istvanzk/WStation/README.md

# Home Weather Station built with Arduino Pro Mini and Raspberry PI (3 A+)

**Note: This repo contains 'release' code and schematics - January 2026 (v3.6)**

## Dependencies

- [OBH Nordica eHome wind meter system 4931][13] (or similar set of sensor)
- [Arduino Pro Mini 328 3.3V/8MHz][8]
- [Raspberry Pi 3 A+][9] and the [7″ touchscreen monitor][11]
- The [forked & modified RadioHead library][1] with support of [RFM22B][2] and [RFM69HCW][10] based radio modules for Raspberry Pi. 
- The original [RadioHead Packet Radio library][3] for embedded microprocessors maintained by Mike McCauley. 
- The original [BCM2835][12] library for Raspbery Pi maintained by Mike McCauley. See [install notes](#BCM2835-library) below.
- Arduino libraries for communication with the [Barometric Pressure Sensor Breakout - BMP180][4] and [Humidity and Temperature Sensor Breakout - SHT15][5]
- Python module for [POSIX IPC Semaphores, Shared Memory and Message Queues][6]
- Pyhton library [Kivy][7]

## GUI (v1.0)
- The main screen - updated every 45 seconds
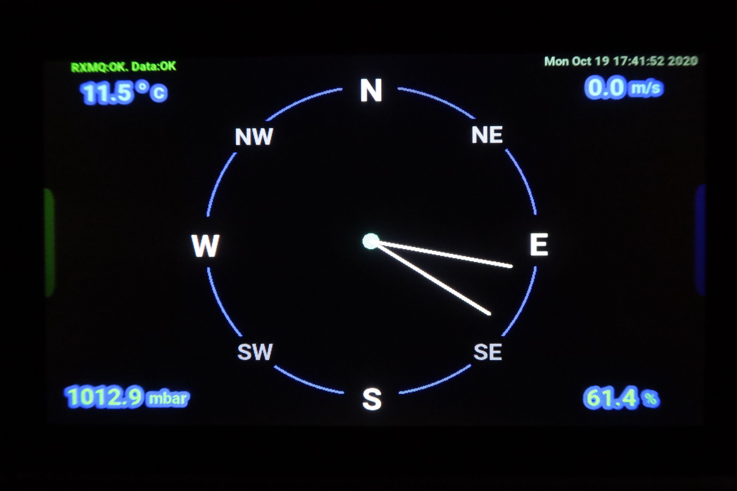
[picture p1: docs/mainscreen.jpg]
Main screen


- The trace screen - for last 15 minutes
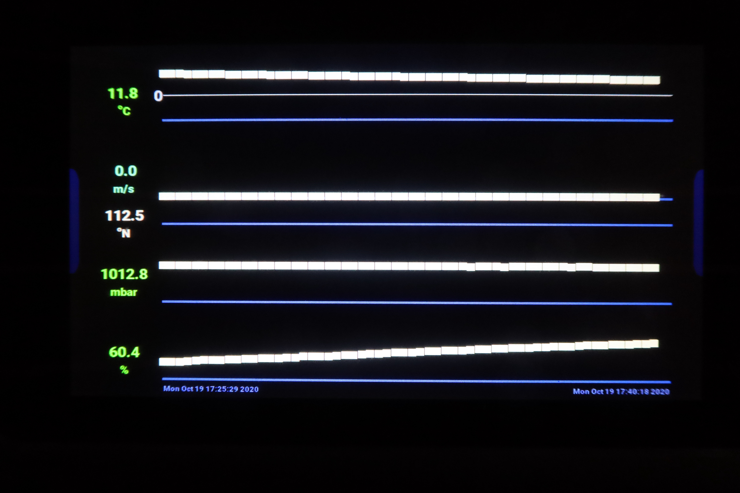
[picture p2: docs/tracescreen.jpg]
Traces screen


## Code structure (v3.6)

*arduino*
- *KiCad*: KiCad circuit diagrams
- *WStation*: code
  - *sensrfm*: client code for collecting weather sensor data and sending it via RFM69HCW or RFM22B radio
  - other folders: test code for sensors and radio

*raspi*
- *KiCad*: KiCad circuit diagrams
- *kivy*: Kivy GUI code (client_mq.py, display.py and screens.kv)
- *rfm*: C code for reading the weather data transmissions via the RFM69HCW or RFM22B radio and sending them via POSIX MessageQueue to the Kivy GUI (server_mq.cpp). See [install notes](#RFM/server_mq) below.

*docs*
- Schematics and pictures

## Install notes

### General dependencies
```
sudo apt install -U build-essential libcap2 libcap-dev libsystemd-dev 
sudo apt install -U python3-kivy python3-systemd
```

### BCM2835 library

Download [BCM2835][12] library and extract it. Based on the [orginal intallation guide][12] follow these steps:
1) Add user to kmem group, allow write access to /dev/mem by members of kmem group, then rreboot and continue with step 2:
```
sudo adduser $USER kmem
echo 'SUBSYSTEM=="mem", KERNEL=="mem", GROUP="kmem", MODE="0660"' | sudo tee /etc/udev/rules.d/98-mem.rules
```
2) Uncomment the #define BCM2835_HAVE_LIBCAP in bcm2835.h
3) Configure with `LIBS=-lcap ./configure`
4) Build and check (`make`, `sudo make check`) and install (`make install`)

### RFM/server_mq

```
make
sudo setcap cap_sys_rawio+ep server_mq
```

[1]: https://github.com/istvanzk/RadioHead
[2]: https://www.hoperf.com/modules/rf_transceiver/RFM22BW.html
[3]: http://www.airspayce.com/mikem/arduino/RadioHead/
[4]: https://github.com/sparkfun/BMP180_Breakout_Arduino_Library
[5]: https://github.com/sparkfun/SHT15_Breakout
[6]: https://github.com/osvenskan/posix_ipc 
[7]: https://kivy.org
[8]: https://www.arduino.cc/en/Main/ArduinoBoardProMini
[9]: https://www.raspberrypi.org/blog/new-product-raspberry-pi-3-model-a
[10]: https://www.hoperf.com/modules/rf_transceiver/RFM69HCW.html
[11]: https://www.raspberrypi.org/products/raspberry-pi-touch-display/
[12]: http://www.airspayce.com/mikem/bcm2835/
[13]: https://github.com/istvanzk/WStation/blob/master/docs/OBHeHome4931.png
