istvanzk/WStation/arduino/WStation/README.md

## Arduino code

The *\*_test* folders contain scripts used to test the individual components connected to the [Arduino board Pro Mini][1].
The final code is in the folder *sensrfm*.

### BOM 
[Arduino board Pro Mini][1]

[RFM22B-S2][2]

[SparkFun Barometric Pressure Sensor Breakout - BMP180][3]

[SparkFun Humidity and Temperature Sensor Breakout - SHT15][4]

[Octal Bus Transceiver Tri-State - 74HC245][5]

### Connections, wiring, sensors

[Full schematics][6]

[1]: https://www.arduino.cc/en/Main/ArduinoBoardProMini
[2]: https://www.sparkfun.com/products/retired/10154
[3]: https://github.com/sparkfun/BMP180_Breakout_Arduino_Library
[4]: https://github.com/sparkfun/SHT15_Breakout
[5]: http://www.futurlec.com/74HC/74HC245.shtml
[6]: https://github.com/istvanzk/WStation/blob/master/docs/arduino_wstation.pdf
