istvanzk/WStation/raspi/KiCad/README.md

## KiCad EDA libraries

These are the [KiCad/EESchema][1] libraries used to generate the Raspberry PI related [schematics files][2] V1.01.

[1]: http://www.kicad-pcb.org
[2]: https://github.com/istvanzk/WStation/tree/master/docs
