istvanzk/WStation/arduino/KiCad/README.md

## KiCad EDA libraries

These are the [KiCad/EESchema][1] libraries used to generate the Arduino related [schematics files][2].

[1]: http://www.kicad-pcb.org
[2]: https://github.com/istvanzk/WStation/tree/master/docs
