istvanzk/WStation/docs/OBHeHome4931.png

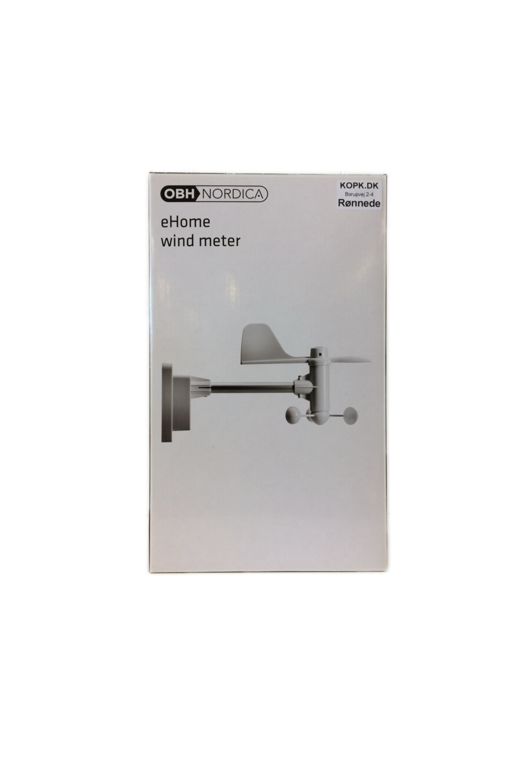
docs/OBHeHome4931.png
