istvanzk/WStation/docs/windsens.png

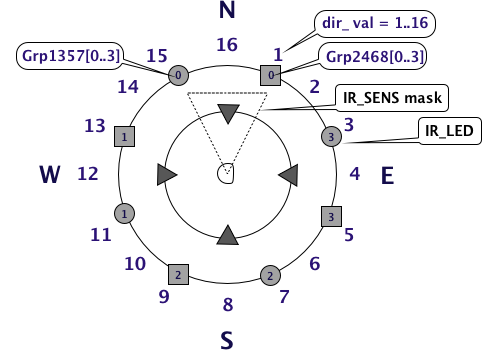
docs/windsens.png
