istvanzk/WStation/docs/arduino_ftdi.pdf

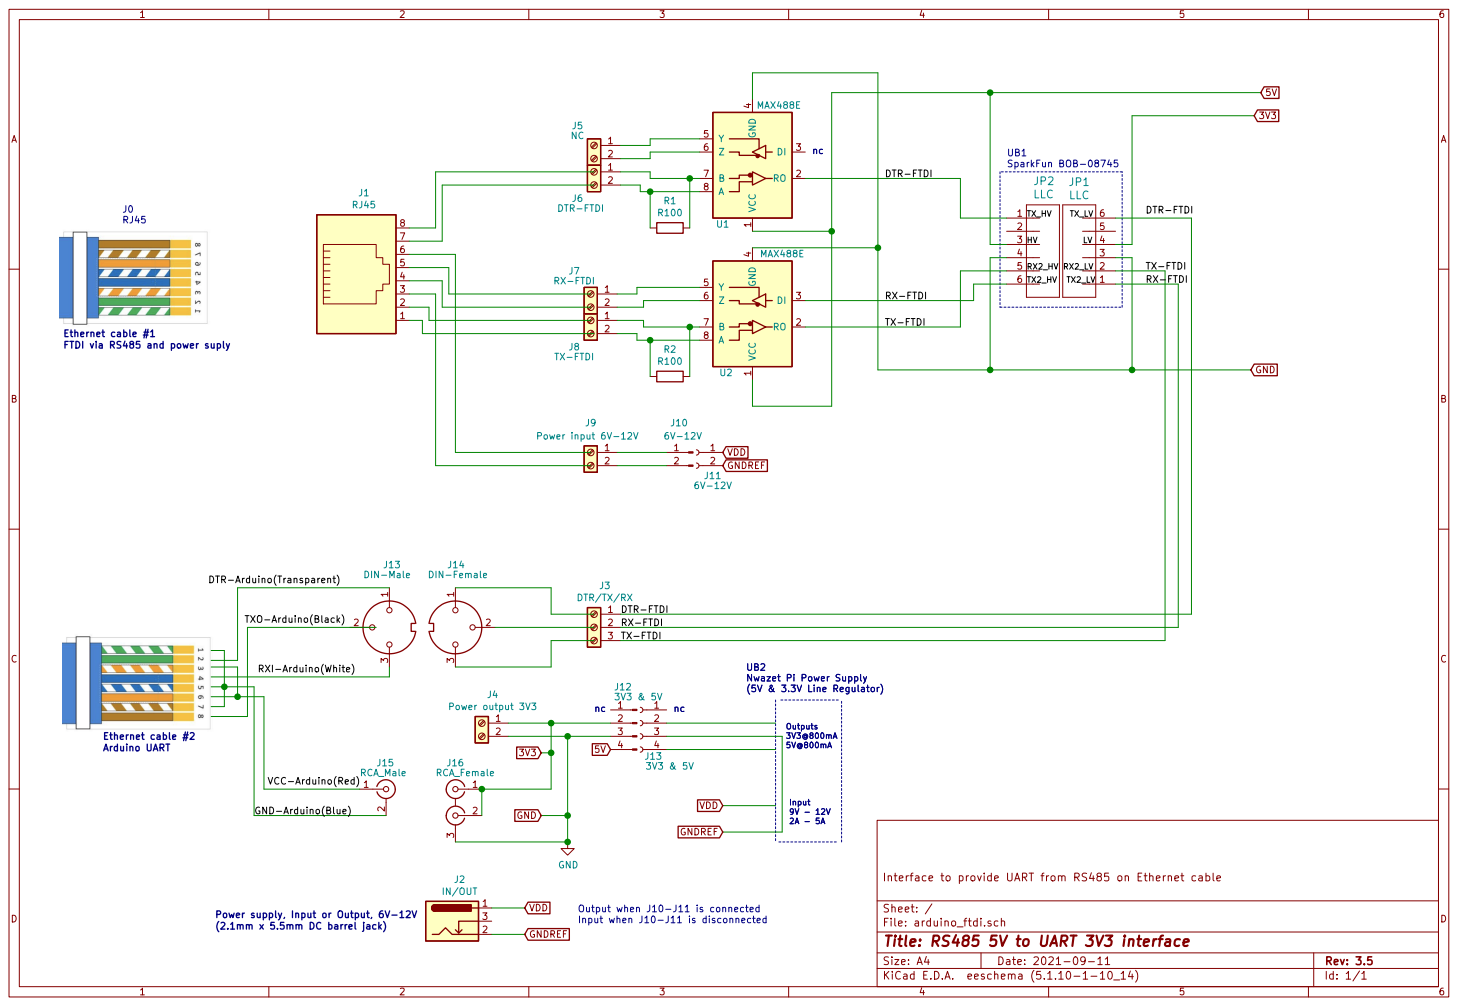
[picture p5: page 1]

Ethernet cable #1 FTDI via RS485 and power suply Ethernet cable #2 Arduino UART

UB1 SparkFun BOB-08745 UB2 Nwazet Pi Power Supply

TX-FTDI DTR-FTDI

5V@800mA UB2 Nwazet Pi Power Supply
2A - 5A Outputs 3V3@800mA

5V@800mA Output when J10-J11 is connected

Interface to provide UART from RS485 on Ethernet cable

File: arduino_ftdi.sch Sheet: /
Id: 1/1 Title: RS485 5V to UART 3V3 interface

Input when J10-J11 is disconnected Power supply, Input or Output, 6V-12V
(2.1mm x 5.5mm DC barrel jack)
