istvanzk/WStation/docs/raspi_wstation.pdf

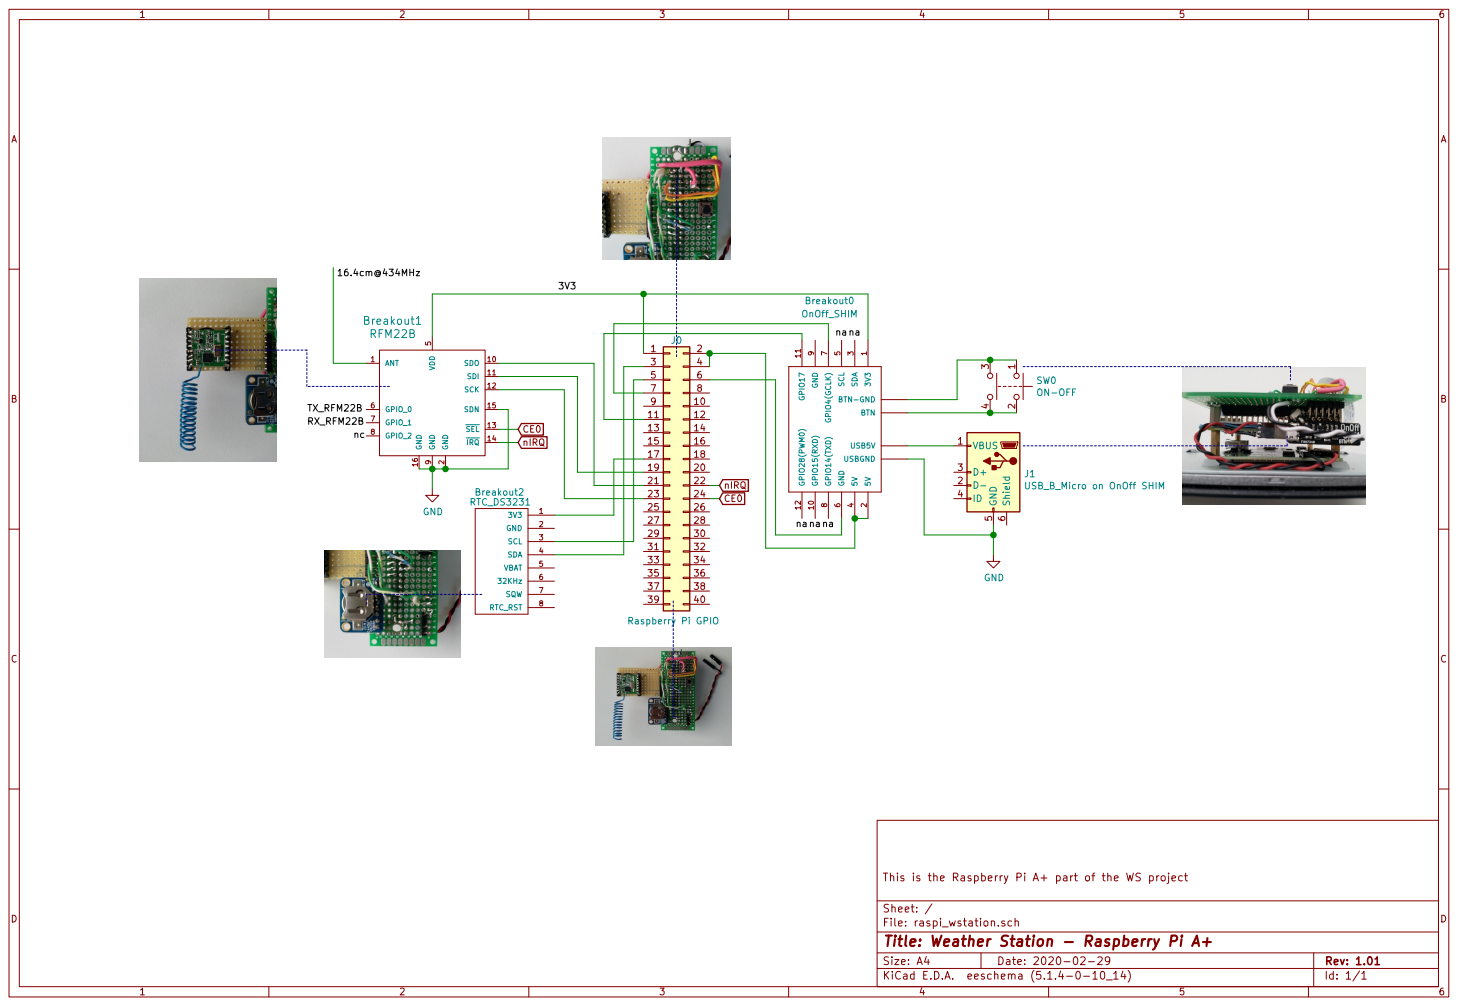
[picture p6: page 1]

9 SDO 10 SDI 11 SCK 12 SEL 13

9 | | 10

File: raspi_wstation.sch Sheet: / This is the Raspberry Pi A+ part of the WS project

Id: 1/1 Title: Weather Station - Raspberry Pi A+
