istvanzk/WStation/docs/usb_ftdi.pdf

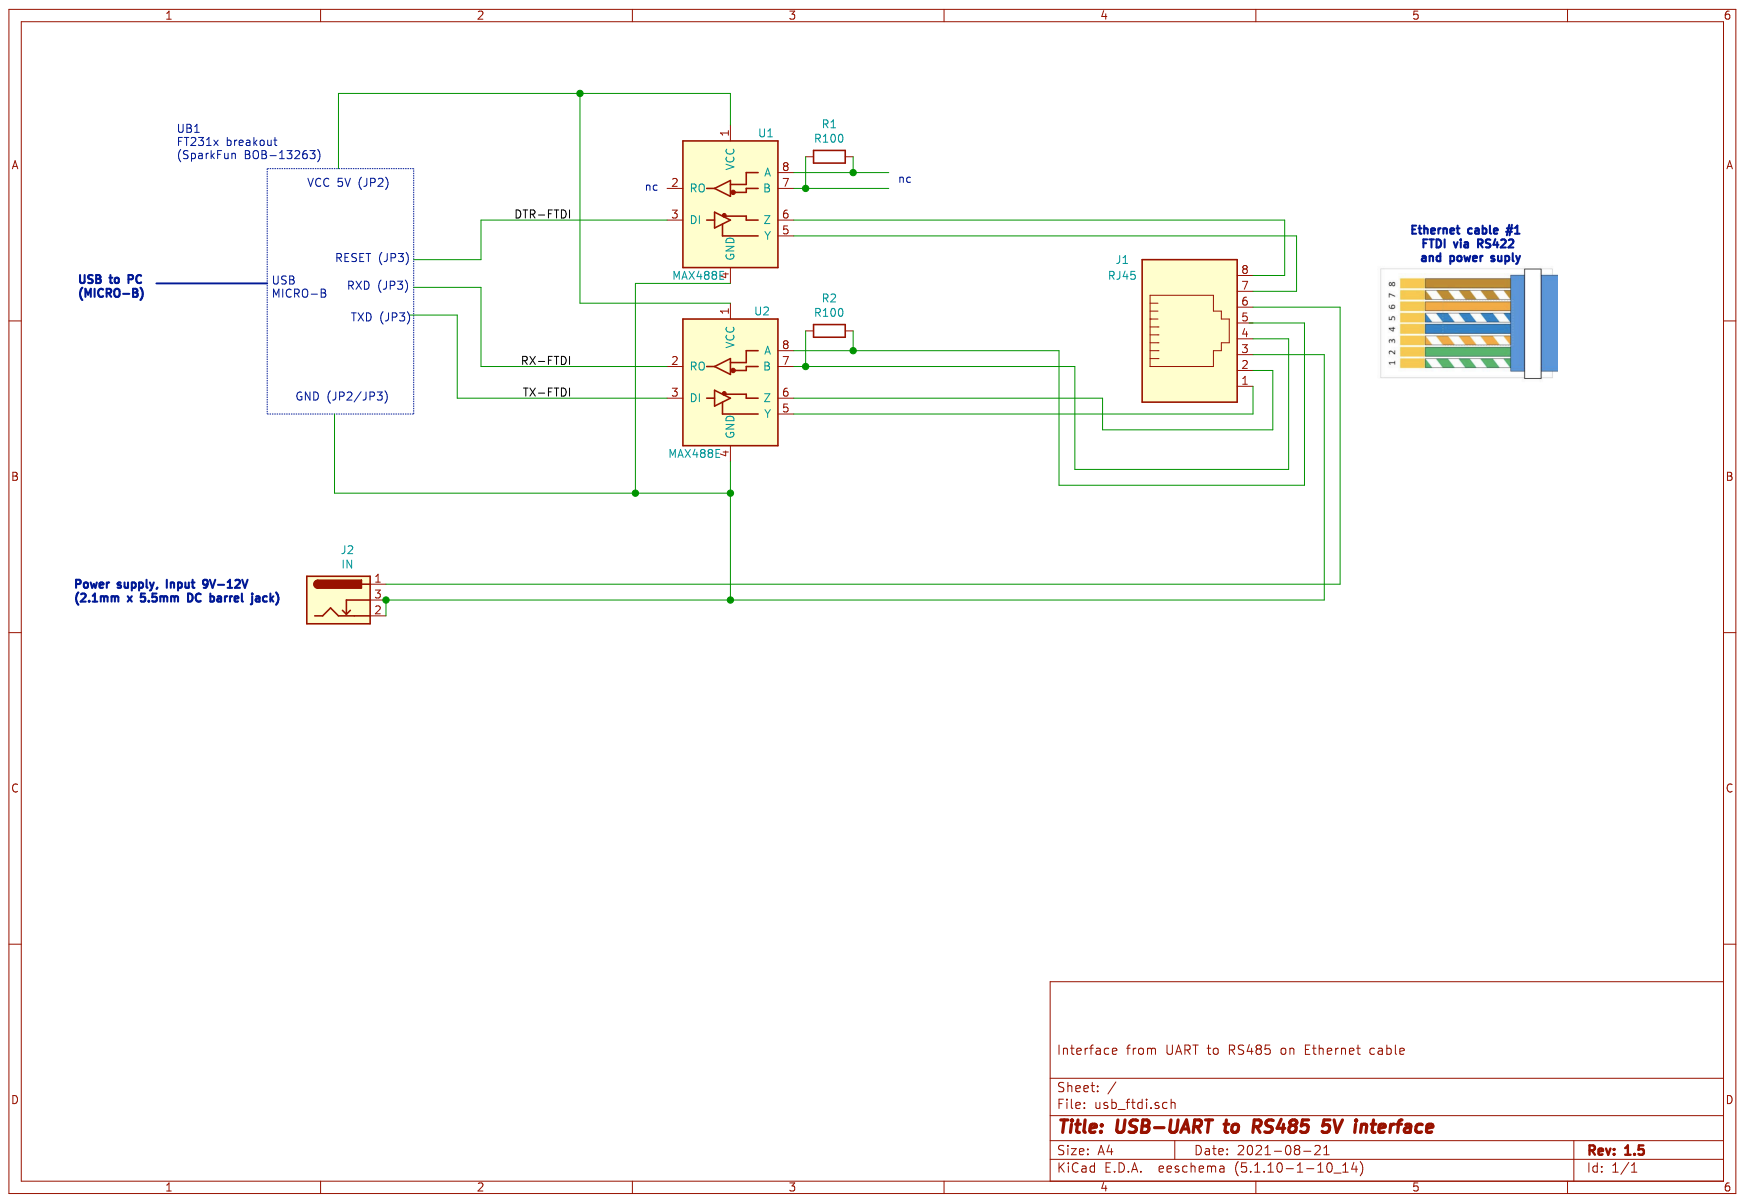
[picture p7: page 1]
