istvanzk/WStation/docs/arduino_wstation_rfm22.pdf

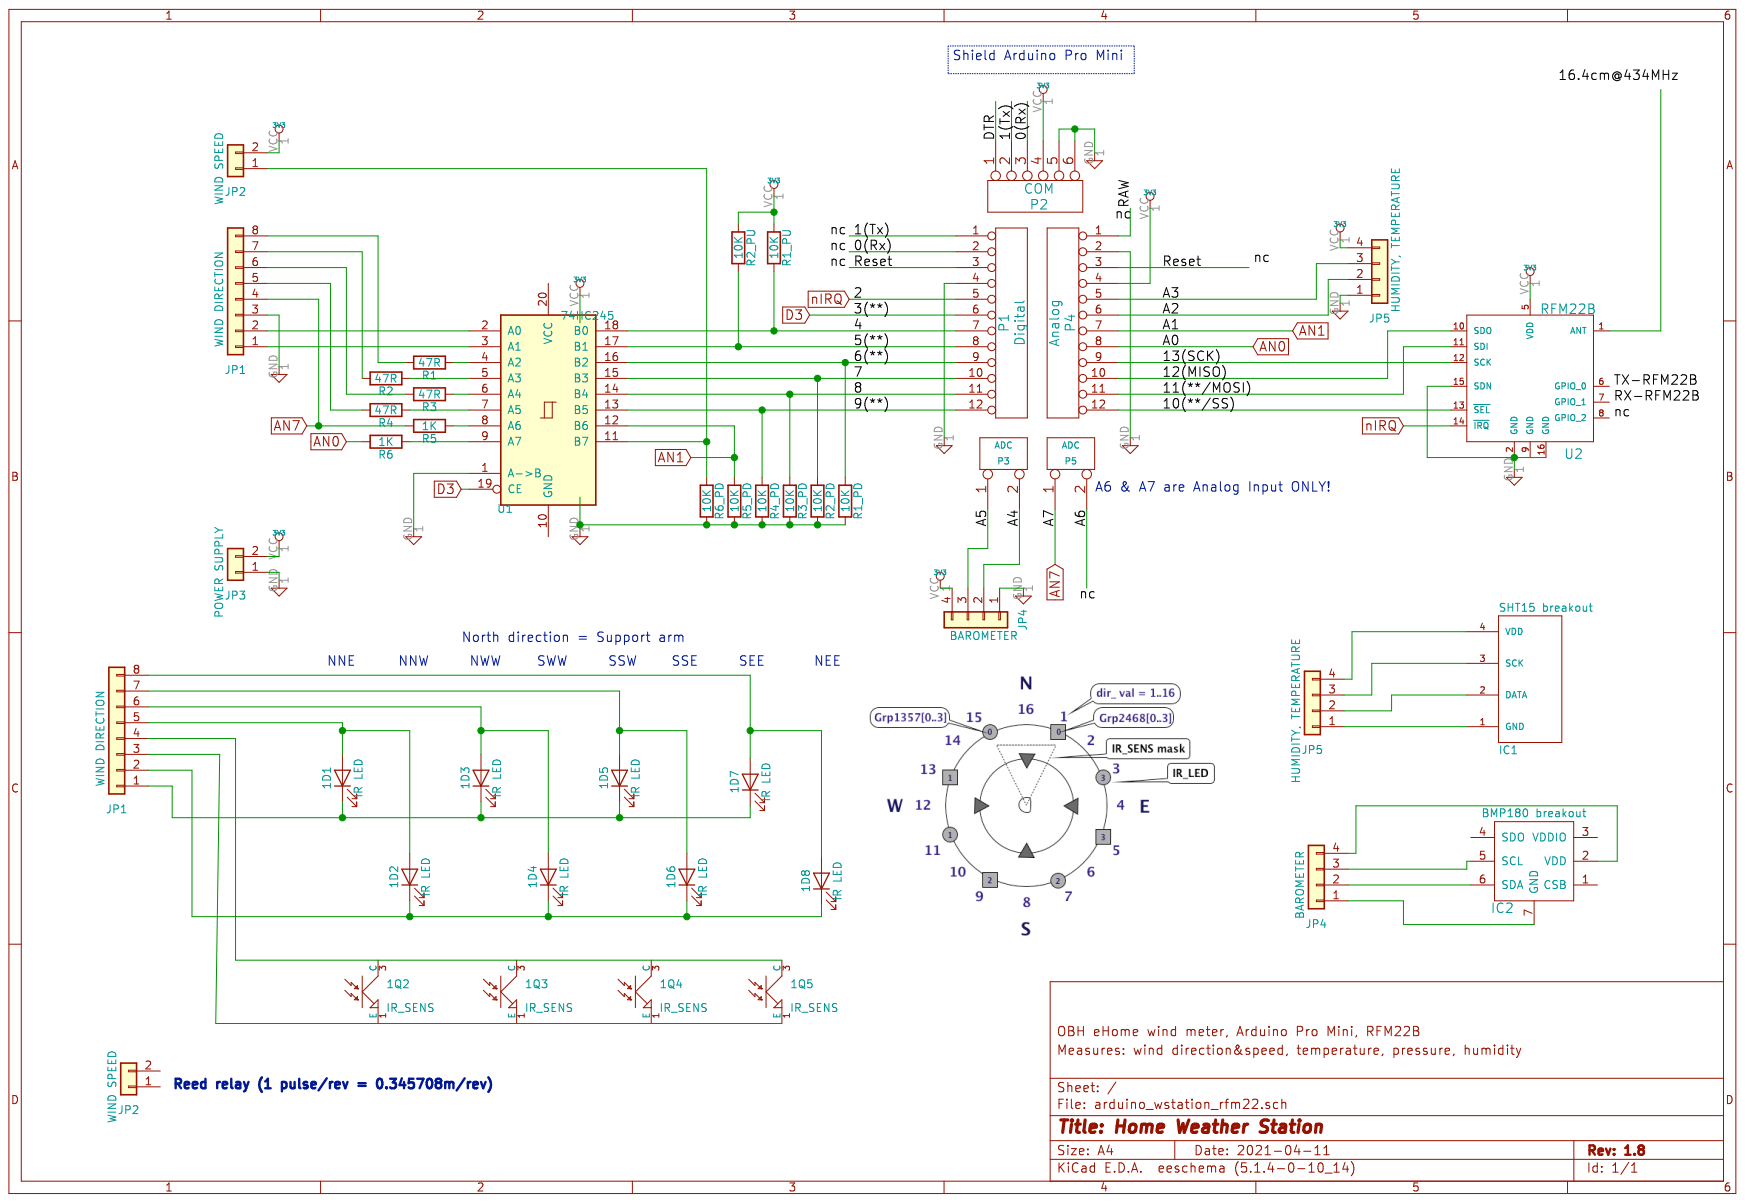
[picture p8: page 1]
