istvanzk/WStation/docs/arduino_wstation_rfm69.pdf

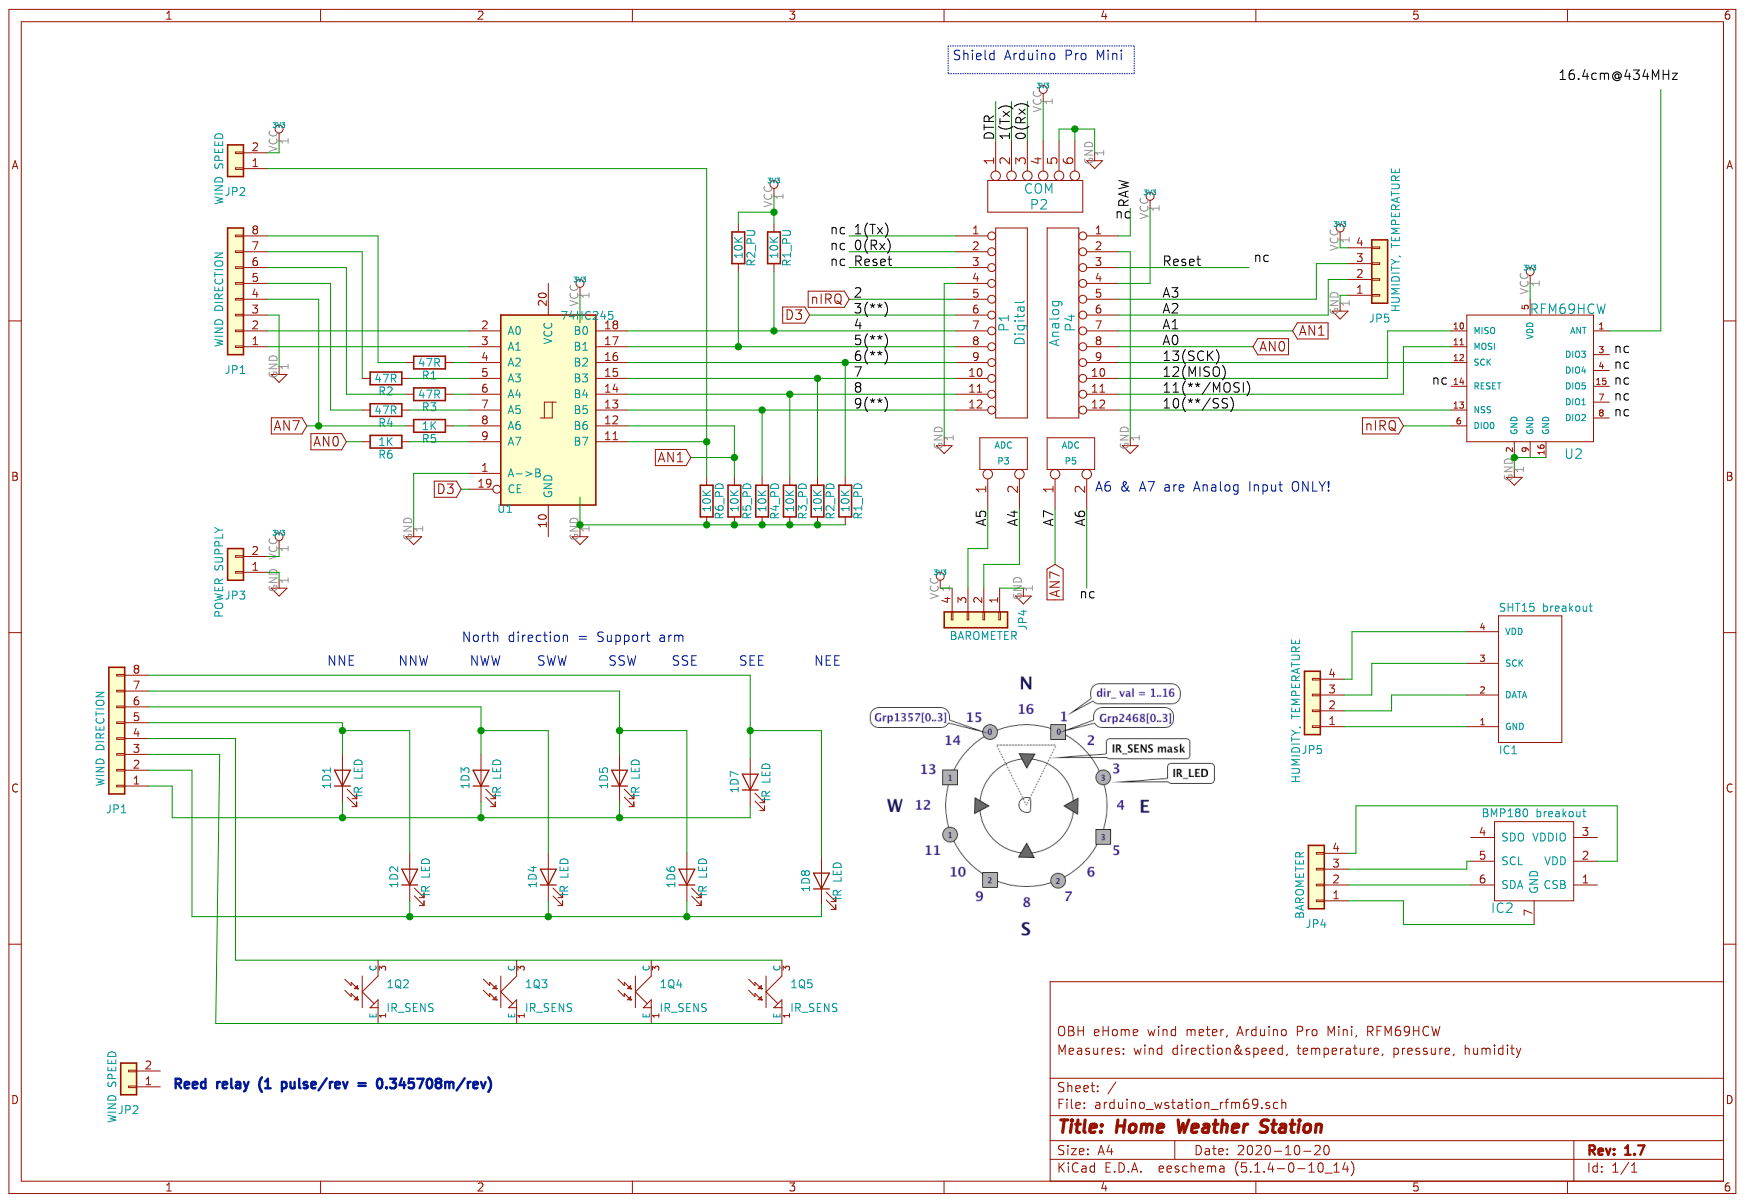
[picture p9: page 1]
