istvanzk/WStation/docs/raspi_wstation_rfm69.pdf

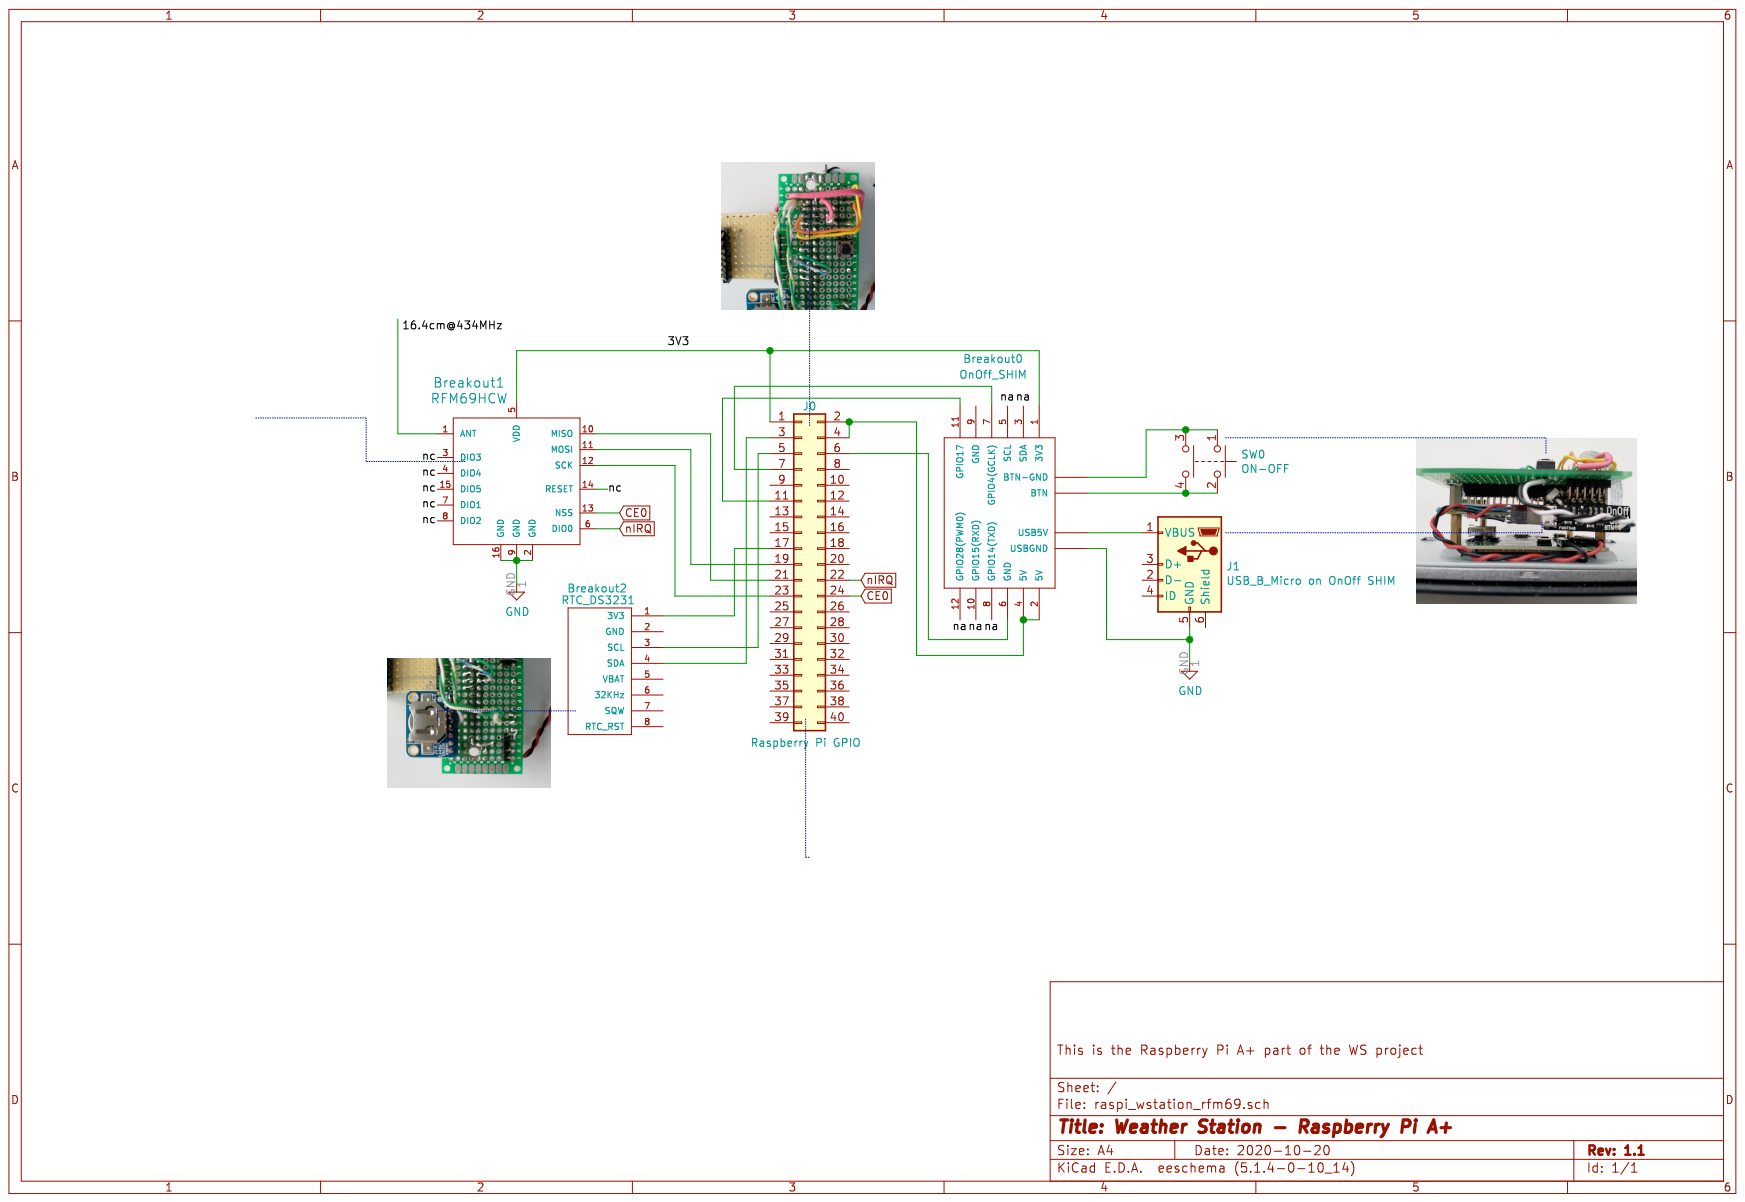
[picture p10: page 1]
