istvanzk/WStation/arduino/KiCad/arduino_wstation_rfm22.sch

## KiCad design arduino/KiCad/arduino_wstation_rfm22.sch (2021-04-11)

Schematic: arduino_wstation_rfm22.sch

Parts:
1D1, 1D2, 1D3, 1D4, 1D5, 1D6, 1D7, 1D8: IR LED
1Q2, 1Q3, 1Q4, 1Q5: IR_SENS
IC1: SHT15 breakout; sht10_11_15-SHT1X
IC2: BMP180 breakout
JP1: WIND DIRECTION
JP2: WIND SPEED
JP3: POWER SUPPLY
JP4: BAROMETER
JP5: HUMIDITY, TEMPERATURE
P1: Digital; Socket_Strip_Arduino_1x12
P2: COM; Socket_Strip_Arduino_1x06
P3, P5: ADC; Socket_Strip_Arduino_1x02
P4: Analog; Socket_Strip_Arduino_1x12
R1, R2, R3, R4: 47R
R1_PD, R1_PU, R2_PD, R2_PU, R3_PD, R4_PD, R5_PD, R6_PD: 10K
R5, R6: 1K
U1: 74HC245
U2: RFM22B

Notes on the sheet:
Shield Arduino Pro Mini
Reed relay (1 pulse/rev = 0.345708m/rev)
A6 & A7 are Analog Input ONLY!
NNE
NNW
NWW
SWW
SSW
SSE
SEE
NEE
North direction = Support arm
