istvanzk/WStation/raspi/KiCad/raspi_wstation_rfm69.sch

## KiCad design raspi/KiCad/raspi_wstation_rfm69.sch (2020-10-22)

Schematic: raspi_wstation_rfm69.sch

Parts:
Breakout0: OnOff_SHIM; ON-OFF Shim (Pimoroni)
Breakout1: RFM69HCW
Breakout2: RTC_DS3231; DS3231 Breakout (Adafruit)
J0: Raspberry Pi GPIO
J1: USB_B_Micro on OnOff SHIM
SW0: ON-OFF
