istvanzk/WStation/arduino/KiCad/arduino_ftdi/arduino_ftdi.sch

## KiCad design arduino/KiCad/arduino_ftdi/arduino_ftdi.sch (2021-09-30)

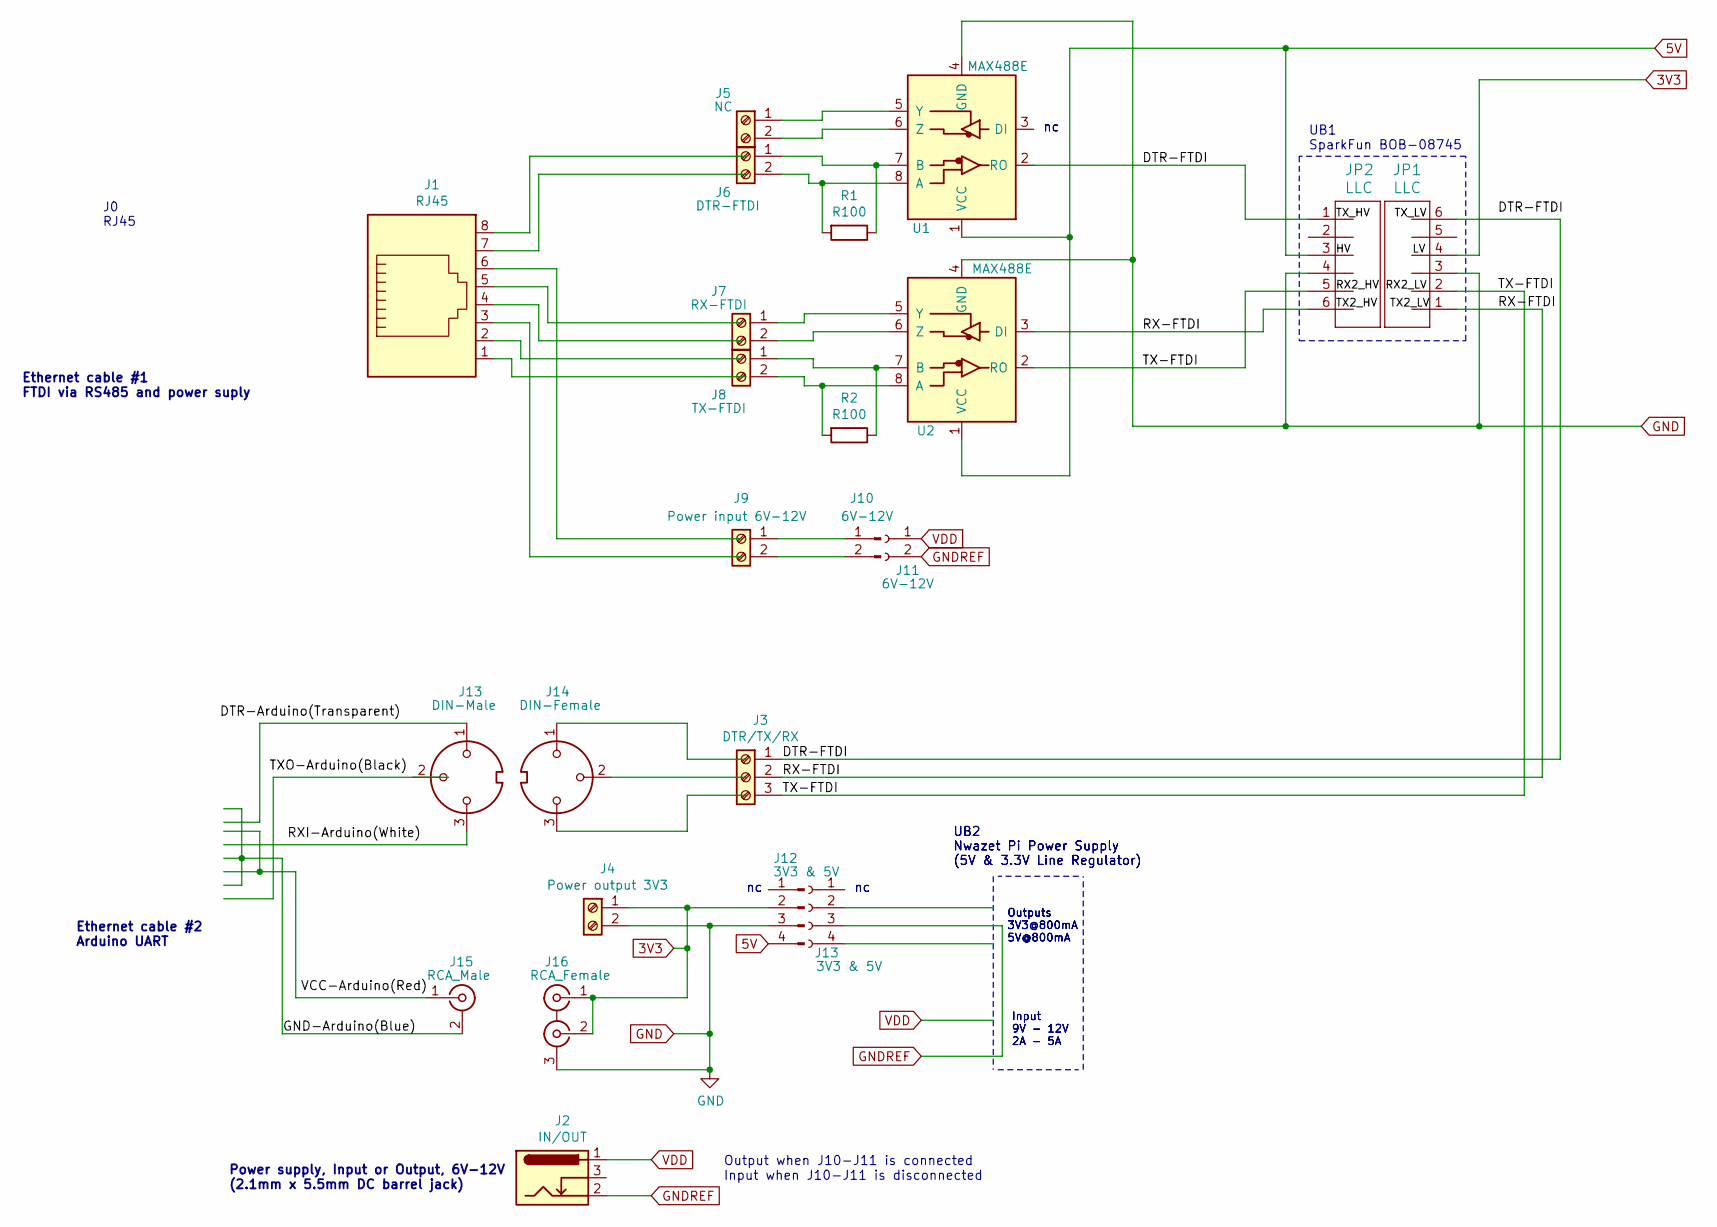
[picture p11: schematic arduino_ftdi.sch]

Parts:
J1: RJ45
J2: IN/OUT
J3: DTR/TX/RX
J4: Power output 3V3
J5: NC
J6: DTR-FTDI
J7: RX-FTDI
J8: TX-FTDI
J9: Power input 6V-12V
J10, J11: 6V-12V
J12, J13: 3V3 & 5V
J14: DIN-Female
J15: RCA_Male
J16: RCA_Female
JP1, JP2: LLC
R1, R2: R100
U1, U2: MAX488E

Connections:
3V3: J4.1, J12.2, J16.1 (IN1), J16.2 (IN2), JP1.4
5V: J12.4, JP2.3, U1.1 (VCC), U2.1 (VCC)
DTR-FTDI: J3.1, JP1.6, JP2.1, U1.2 (RO)
GND: J4.2, J12.3, J16.3 (EXT), JP1.3, JP2.4, U1.4 (GND), U2.4 (GND)
GND-Arduino(Blue): J15.2 (Ext)
GNDREF: J2.2, J11.2, J13.3
unnamed: J5.1, U1.5 (Y)
unnamed: J5.2, U1.6 (Z)
unnamed: J6.1, R1.1, U1.7 (B)
unnamed: J6.2, R1.2, U1.8 (A)
unnamed: J7.1, U2.5 (Y)
unnamed: J7.2, U2.6 (Z)
unnamed: J8.1, R2.1, U2.7 (B)
unnamed: J8.2, R2.2, U2.8 (A)
unnamed: J9.1, J10.1
unnamed: J9.2, J10.2
RX-FTDI: J3.2, JP1.1, JP2.6, U2.3 (DI)
TX-FTDI: J3.3, JP1.2, JP2.5, U2.2 (RO)
VDD: J2.1, J11.1

Notes on the sheet:
UB2 Nwazet Pi Power Supply (5V & 3.3V Line Regulator)
Outputs 3V3@800mA 5V@800mA
Input 9V - 12V 2A - 5A
Ethernet cable #2 Arduino UART
Ethernet cable #1 FTDI via RS485 and power suply
Power supply, Input or Output, 6V-12V (2.1mm x 5.5mm DC barrel jack)
Output when J10-J11 is connected Input when J10-J11 is disconnected
UB1 SparkFun BOB-08745
J0 RJ45
