istvanzk/WStation/arduino/KiCad/arduino_ftdi/usb_ftdi.sch

## KiCad design arduino/KiCad/arduino_ftdi/usb_ftdi.sch (2021-08-21)

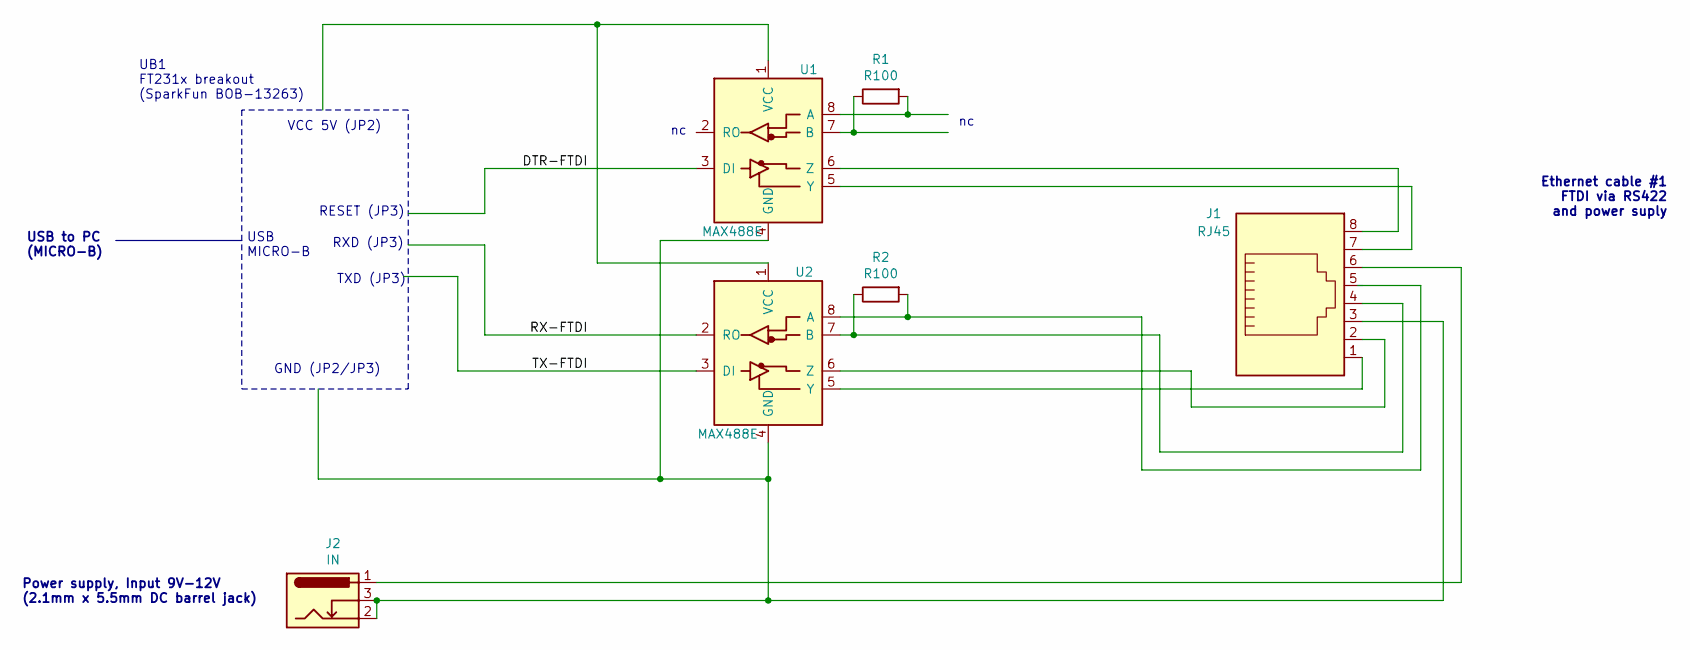
[picture p12: schematic usb_ftdi.sch]

Parts:
J1: RJ45
J2: IN
R1, R2: R100
U1, U2: MAX488E

Connections:
DTR-FTDI: U1.3 (DI)
unnamed: J1.1, U2.5 (Y)
unnamed: J1.2, U2.6 (Z)
unnamed: J1.3, J2.2, J2.3, U1.4 (GND), U2.4 (GND)
unnamed: J1.4, R2.1, U2.7 (B)
unnamed: J1.6, J2.1
unnamed: J1.7, U1.5 (Y)
unnamed: J1.8, U1.6 (Z)
unnamed: R1.1, U1.7 (B)
unnamed: R1.2, U1.8 (A)
unnamed: R2.2, U2.8 (A)
unnamed: U1.1 (VCC), U2.1 (VCC)
RX-FTDI: U2.2 (RO)
TX-FTDI: U2.3 (DI)

Notes on the sheet:
Power supply, Input 9V-12V (2.1mm x 5.5mm DC barrel jack)
Ethernet cable #1 FTDI via RS422 and power suply
TXD (JP3)
RXD (JP3)
RESET (JP3)
GND (JP2/JP3)
VCC 5V (JP2)
USB MICRO-B
USB to PC (MICRO-B)
UB1 FT231x breakout (SparkFun BOB-13263)
