istvanzk/WStation/arduino/WStation/BMPSHT_test/BMPSHT_test.ino

/* SFE_BMP180 + SHT15 test sketch
 
Sketch uses 10,026 bytes (32%) of program storage space. Maximum is 30,720 bytes.
Global variables use 901 bytes (43%) of dynamic memory, leaving 1,147 bytes for local variables. Maximum is 2,048 bytes.

This sketch shows how to use:
1) the SFE_BMP180 library to read the Bosch BMP180 barometric pressure sensor.
https://www.sparkfun.com/products/11824
2) the SHT1x library to get the temperature in F or C and humidity from SHT15 humidity sensor.
https://www.sparkfun.com/products/13683

BMP180 Connections:
GND  -> GND
Vcc  -> Vcc
DATA -> A4/SDA
SCK  -> A5/SCL

SHT15 Connections:
GND  -> GND
Vcc  -> Vcc
DATA -> A2
SCK  -> A3

Requires:
Sparkfun BMP180 Arduino Library: https://github.com/sparkfun/BMP180_Breakout
SparkFun_SHT1X Arduino Library: https://github.com/sparkfun/SHT15_Breakout/

Output:

BMP data:
 provided altitude: 40 meters, 131 feet
 temperature: 19.89 C, 67.81 F
 absolute pressure: 1010.98 mb, 29.86 inHg
 relative (sea-level) pressure: 1015.79 mb, 30.00 inHg
 computed altitude: 40 meters, 131 feet
SHT data:
 temperature: 19.68 C, 67.48 F
 humidity: 69.84%

---
Like most pressure sensors, the BMP180 measures absolute pressure.
This is the actual ambient pressure seen by the device, which will
vary with both altitude and weather.

Before taking a pressure reading you must take a temparture reading.
This is done with startTemperature() and getTemperature().
The result is in degrees C.

Once you have a temperature reading, you can take a pressure reading.
This is done with startPressure() and getPressure().
The result is in millibar (mb) aka hectopascals (hPa).

If you'll be monitoring weather patterns, you will probably want to
remove the effects of altitude. This will produce readings that can
be compared to the published pressure readings from other locations.
To do this, use the sealevel() function. You will need to provide
the known altitude at which the pressure was measured.

If you want to measure altitude, you will need to know the pressure
at a baseline altitude. This can be average sealevel pressure, or
a previous pressure reading at your altitude, in which case
subsequent altitude readings will be + or - the initial baseline.
This is done with the altitude() function.

Leave the IO (VDDIO) pin unconnected. This pin is for connecting
the BMP180 to systems with lower logic levels such as 1.8V

The SFE_BMP180 library uses floating-point equations developed by the
Weather Station Data Logger project: http://wmrx00.sourceforge.net/

Based on SFE_BMP180 library example sketch:
	V10 Mike Grusin, SparkFun Electronics 10/24/2013
	V1.1.2 Updates for Arduino 1.6.4 5/2015
Based on SHT15 Example:
	Joel Bartlett @ SparkFun Electronics
	16 Sept 2015
*/

// Your sketch must #include this library, and the Wire library.
// (Wire is a standard library included with Arduino.):

#include <Arduino.h>
#include <SFE_BMP180.h>
#include <SHT1X.h>
#include <Wire.h>

// SFE_BMP180 object "pressure":
SFE_BMP180 pressure;

// SHT1x object, "sht15"
SHT1x sht15(A2, A3); //Data, SCK

// Reference altitude of Frydendal, Aalborg in meters
#define ALTITUDE 40.0 

// Variables for storing values


void setup()
{
  Serial.begin(9600);
  Serial.println("REBOOT");

  // Initialize the BMP180 sensor (it is important to get calibration values stored on the device).
  if (pressure.begin())
    Serial.println("BMP180 init success");
  else
  {
    // Oops, something went wrong, this is usually a connection problem,
    // see the comments at the top of this sketch for the proper connections.

    Serial.println("BMP180 init fail\n\n");
    while(1); // Pause forever.
  }
  
  Serial.println("SHT15 init");
  
}

void loop()
{
  char status;
  double T,P,p0,a;

  float tempC = 0;
  float tempF = 0;
  float humidity = 0;

  Serial.println();

  // If you want sea-level-compensated pressure, as used in weather reports,
  // you will need to know the altitude at which your measurements are taken.
  // We're using a constant called ALTITUDE in this sketch:  
  Serial.println("BMP data:");
  Serial.print(" provided altitude: ");
  Serial.print(ALTITUDE,0);
  Serial.print(" meters, ");
  Serial.print(ALTITUDE*3.28084,0);
  Serial.println(" feet");
  
  // If you want to measure altitude, and not pressure, you will instead need
  // to provide a known baseline pressure. This is shown at the end of the sketch.

  // You must first get a temperature measurement to perform a pressure reading.
  
  // Start a temperature measurement:
  // If request is successful, the number of ms to wait is returned.
  // If request is unsuccessful, 0 is returned.

  status = pressure.startTemperature();
  if (status != 0)
  {
    // Wait for the measurement to complete:
    delay(status);

    // Retrieve the completed temperature measurement:
    // Note that the measurement is stored in the variable T.
    // Function returns 1 if successful, 0 if failure.

    status = pressure.getTemperature(T);
    if (status != 0)
    {
      // Print out the measurement:
      Serial.print(" temperature: ");
      Serial.print(T,2);
      Serial.print(" C, ");
      Serial.print((9.0/5.0)*T+32.0,2);
      Serial.println(" F");
      
      // Start a pressure measurement:
      // The parameter is the oversampling setting, from 0 to 3 (highest res, longest wait).
      // If request is successful, the number of ms to wait is returned.
      // If request is unsuccessful, 0 is returned.

      status = pressure.startPressure(3);
      if (status != 0)
      {
        // Wait for the measurement to complete:
        delay(status);

        // Retrieve the completed pressure measurement:
        // Note that the measurement is stored in the variable P.
        // Note also that the function requires the previous temperature measurement (T).
        // (If temperature is stable, you can do one temperature measurement for a number of pressure measurements.)
        // Function returns 1 if successful, 0 if failure.

        status = pressure.getPressure(P,T);
        if (status != 0)
        {
          // Print out the measurement:
          Serial.print(" absolute pressure: ");
          Serial.print(P,2);
          Serial.print(" mb, ");
          Serial.print(P*0.0295333727,2);
          Serial.println(" inHg");

          // The pressure sensor returns abolute pressure, which varies with altitude.
          // To remove the effects of altitude, use the sealevel function and your current altitude.
          // This number is commonly used in weather reports.
          // Parameters: P = absolute pressure in mb, ALTITUDE = current altitude in m.
          // Result: p0 = sea-level compensated pressure in mb

          p0 = pressure.sealevel(P,ALTITUDE); // we're at 1655 meters (Boulder, CO)
          Serial.print(" relative (sea-level) pressure: ");
          Serial.print(p0,2);
          Serial.print(" mb, ");
          Serial.print(p0*0.0295333727,2);
          Serial.println(" inHg");

          // On the other hand, if you want to determine your altitude from the pressure reading,
          // use the altitude function along with a baseline pressure (sea-level or other).
          // Parameters: P = absolute pressure in mb, p0 = baseline pressure in mb.
          // Result: a = altitude in m.

          a = pressure.altitude(P,p0);
          Serial.print(" computed altitude: ");
          Serial.print(a,0);
          Serial.print(" meters, ");
          Serial.print(a*3.28084,0);
          Serial.println(" feet");
        }
        else Serial.println("error retrieving BMP pressure measurement\n");
      }
      else Serial.println("error starting BMP pressure measurement\n");
    }
    else Serial.println("error retrieving BMP temperature measurement\n");
  }
  else Serial.println("error starting BMP temperature measurement\n");

  // Read values from the SHT15 sensor
  tempC = sht15.readTemperatureC();
  tempF = sht15.readTemperatureF();
  humidity = sht15.readHumidity();  
  
  // Print info	
  Serial.println("SHT data:");
  Serial.print(" temperature: ");
  Serial.print(tempC);
  Serial.print(" C, ");
  Serial.print(tempF);
  Serial.println(" F");
  Serial.print(" humidity: ");
  Serial.print(humidity); 
  Serial.println("%");


  delay(5000);  // Pause for 5 seconds.
}
