istvanzk/WStation/(commit log)

2019-11-03 Initialise folders
    [arduino_wstation.sch]
2019-11-04 Add BOM and connections summary.
2019-11-04 Add info about KiCad libraries.
2019-11-04 Add KiCad folder
2019-11-05 Move sch, pro and rescue.lib files
    [arduino_wstation.sch]
2019-11-05 SCH file moved.
    [arduino_wstation.sch]
2019-11-05 Updated schematics pdf
2020-02-24 Add Raspberry Pi diagram
    [raspi_wstation.sch]
2020-02-24 Update Arduino diagram
2020-02-29 Update schematics with pictures
    [raspi_wstation.sch]
2020-08-18 Update arduino schematics. Add final code
    [arduino_wstation.sch]
2020-08-30 Handle the case when the posix_ipc message queue cannot be inialised
2020-08-30 Handle the case when no new weather data has been received
2020-08-30 Handle the case when receive from message queue times out
2020-09-01 Rename screens. Add rounded navigation buttons
2020-09-02 Update RoundedButton. Add deques to store weather data traces
2020-09-10 Refactor code. Add display screens for trace24 and trace15
2020-09-15 The schematics for the RS422 to UART interface
    [arduino_ftdi.sch]
2020-09-16 Updated RS422 to UART schematics. Add UART to RS422 schematics
    [arduino_ftdi.sch, usb_ftdi.sch]
2020-09-21 Update self._rssi_dBm from header. Handle case when no new data is received
2020-09-22 Adjust trace screen text. Add time display to main screen. Add small mode window in the settings
2020-09-22 Adjust text on the main and traces screens
2020-09-24 Adjust text positions on the traces screen
2020-09-24 Adjust time and temperature text display
2020-09-28 Correct first message sent to the queue
    [server_mq.cpp]
2020-09-28 Correct color of the GND wire to Arduino
    [arduino_ftdi.sch]
2020-10-01 Remove progress bar from traces screens
2020-10-16 Correct use of RH_RFM_MAX_MESSAGE_LEN; start adding systemd functionality
    [server_mq.cpp]
2020-10-18 Correct message length; do not set RH_RF69_MAX_MESSAGE_LEN
    [sensrfm.ino]
2020-10-22 Add schematics for RFM69HCW
    [arduino_wstation_rfm69.sch, raspi_wstation_rfm69.sch]
2020-10-22 Correct pressure trace scaling.
2021-03-06 Updated schematics: correct RJ45 pinout
2021-04-11 Update ftdi interfaces (remove the unnecesary load resistors)
    [arduino_ftdi.sch, usb_ftdi.sch]
2021-04-11 Update Arduino-RFM22B and Arduino-RFM69 schematics files
    [arduino_wstation.sch, arduino_wstation_rfm22.sch, arduino_wstation_rfm69.sch]
2021-08-21 Update FTDI interface schematics
    [arduino_ftdi_r2.4.sch, usb_ftdi.sch]
2021-08-21 Schematics of the used boards
2021-09-30 Update schematics: new connectors
    [arduino_ftdi.sch]
2021-09-30 Remove older schematics
    [arduino_ftdi_r2.4.sch]
2021-10-10 Change display scale for pressure and humidity traces
2021-10-14 Handle socket and request exceptions
2021-10-21 Adjust scaling for pressure traces. Adjust x_step calculation.
2021-10-22 Adjust switch glitch filter to allow for higher mesured speeds
    [sensrfm.ino]
2021-10-23 Adjust humidity and pressure traces scale
2021-10-23 Adjust pressure trace scale
2021-10-23 Disable interrupts when reading the anemometer value
2021-10-23 Disable/enable interrupts during TIMER2_OVF_vect ISR
2021-11-23 Fix negative temperature encoding and decoding
    [sensrfm.ino]
2021-11-25 Correct negative temp encoding
    [sensrfm.ino]
